irxd/diy_louder/gallery/IMG_3398.jpg

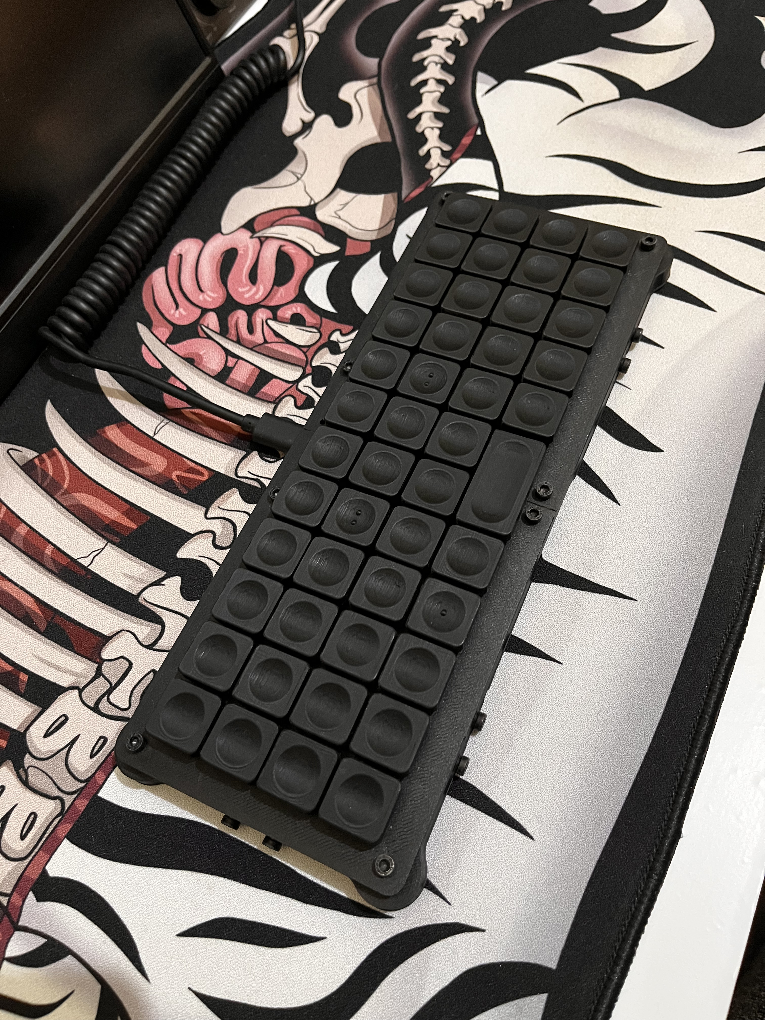
gallery/IMG_3398.jpg
