irxd/diy_louder/gallery/IMG_3399.jpg

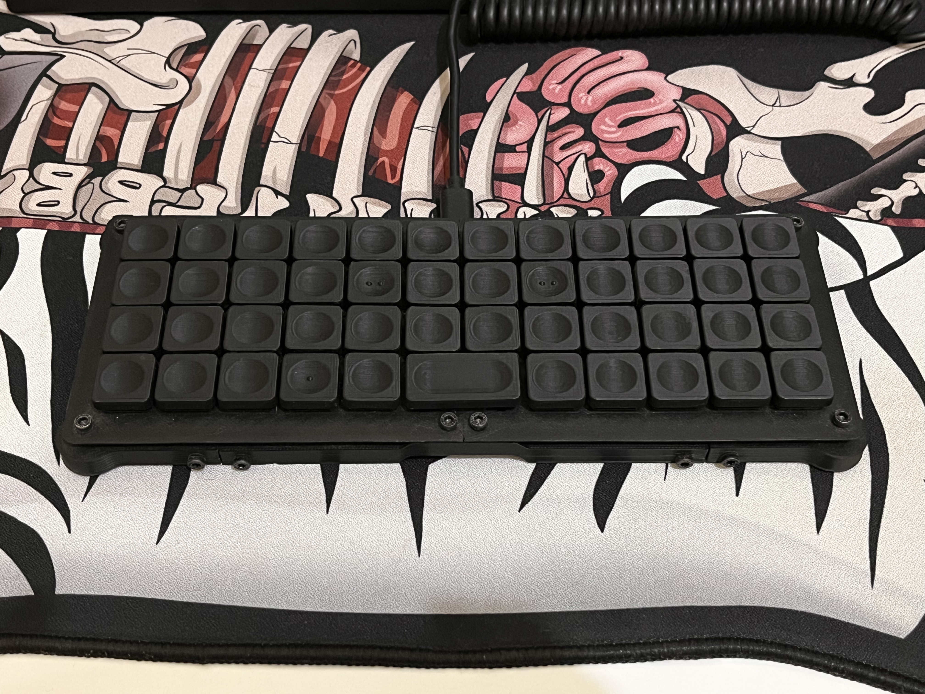
gallery/IMG_3399.jpg
