irxd/diy_louder/gallery/IMG_3400.jpg

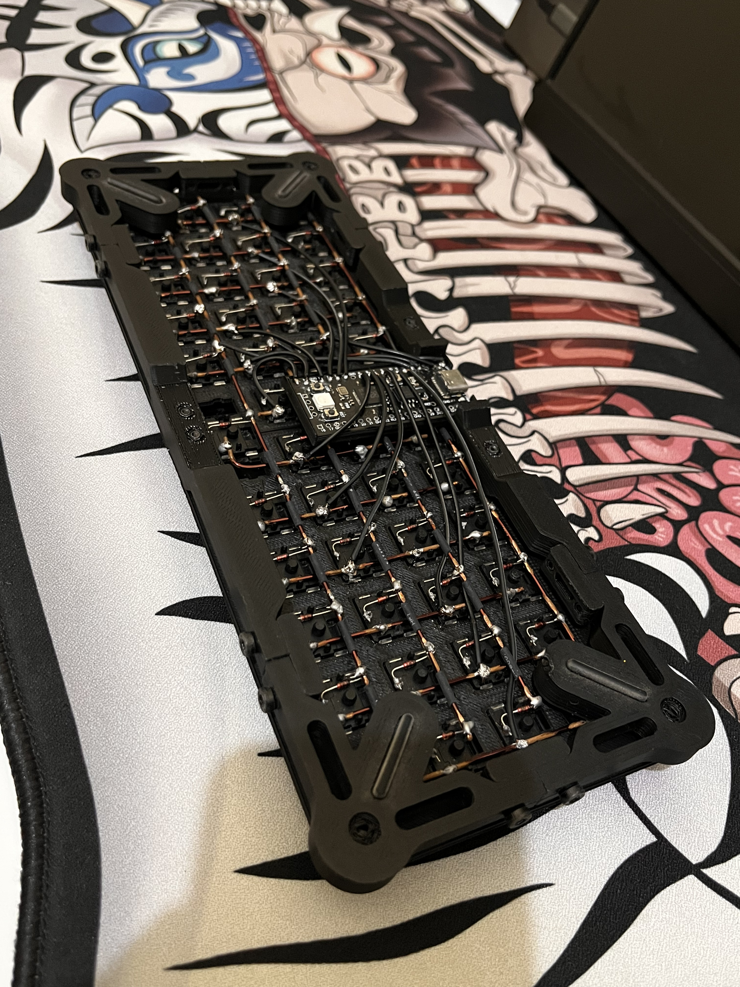
gallery/IMG_3400.jpg
