irxd/diy_louder/model/corner.stl

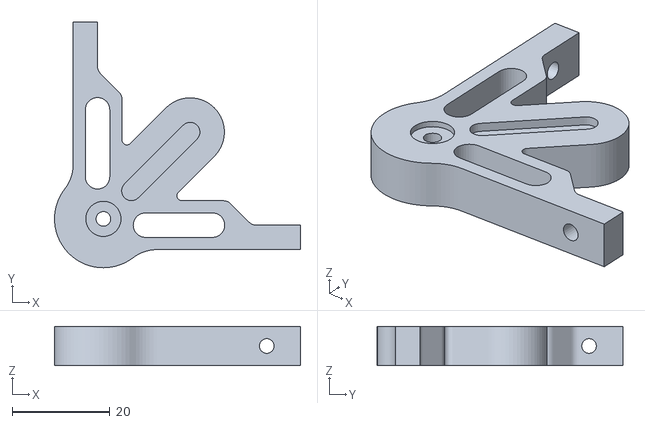
[picture p5: CAD file, 2026-10-17]
model/corner.stl
50.3 x 50.2 x 8.00
