irxd/diy_louder/model/spacer.stl

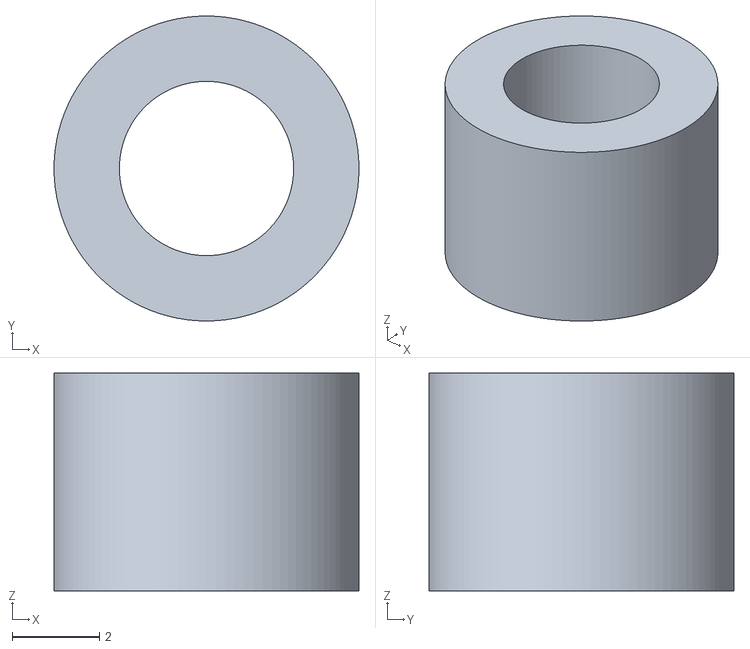
[picture p6: CAD file, 2026-10-17]
model/spacer.stl
7.00 x 7.00 x 5.00
