irxd/diy_louder/model/plate-left.stl

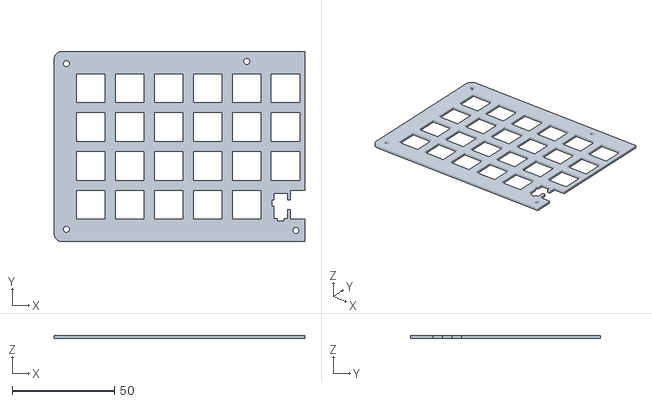
[picture p7: CAD file, 2026-10-17]
model/plate-left.stl
122.8 x 93.2 x 1.50
