irxd/diy_louder/model/front-bridge.stl

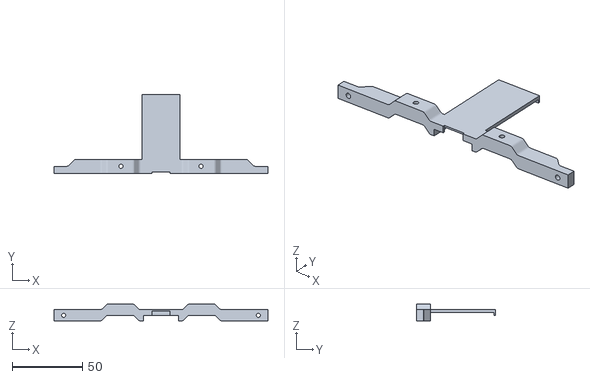
[picture p8: CAD file, 2026-10-17]
model/front-bridge.stl
152.4 x 56.0 x 12.0
