irxd/diy_louder/model/bridge.stl

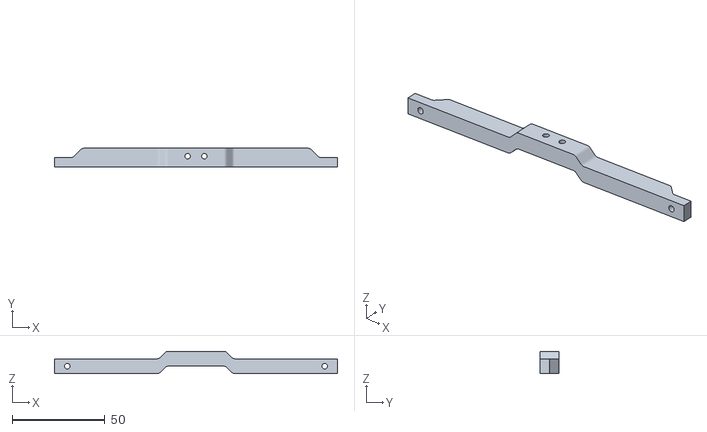
[picture p9: CAD file, 2026-10-17]
model/bridge.stl
152.4 x 10.00 x 12.0
