irxd/diy_louder/model/connector.stl

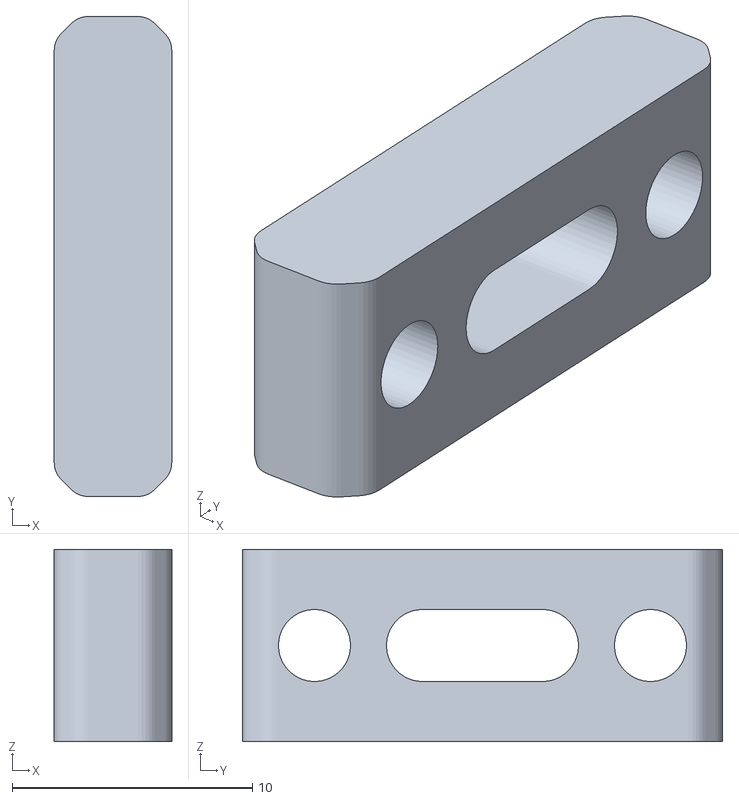
[picture p10: CAD file, 2026-10-17]
model/connector.stl
4.90 x 20.0 x 8.00
