irxd/diy_louder/model/diy-louder.step

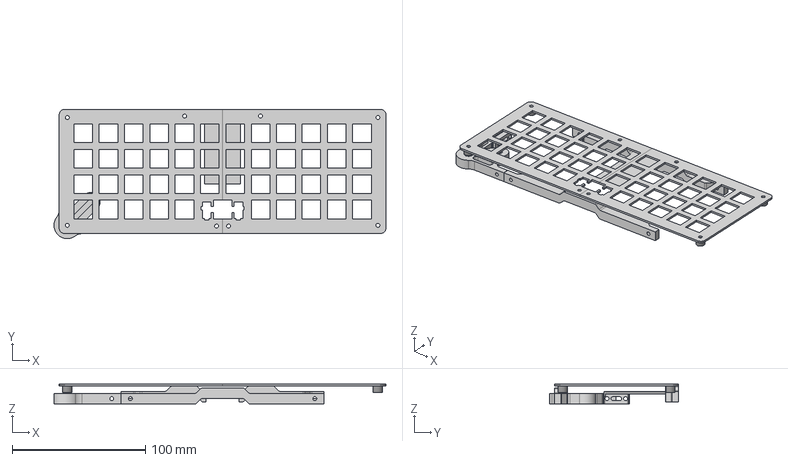
[picture p11: CAD file, 2026-10-17]
model/diy-louder.step
249.5 x 97.1 x 15.0 mm
plate
spacer
spacer (1)
spacer (1) (1)
spacer (1) (2)
corner
connector
bridge
bridge (1)
