irxd/diy_louder/(list of files, cad)

Other CAD files:
model/plate-right.stl
