irxd/diy_louder/(commit log)

2026-10-16 docs: add to-do list for layout, 3D models, and BOM in readme
2026-10-17 feat: add model, component list, detailed keymap
    [bridge.stl, connector.stl, corner.stl, diy-louder.step, front-bridge.stl, plate-left.stl, plate-right.stl, spacer.stl]
2026-10-17 docs: update screw length from M3x16 to M3x10 in BOM
